vladgava/planck-led-esp32/planck_fit_ro.png

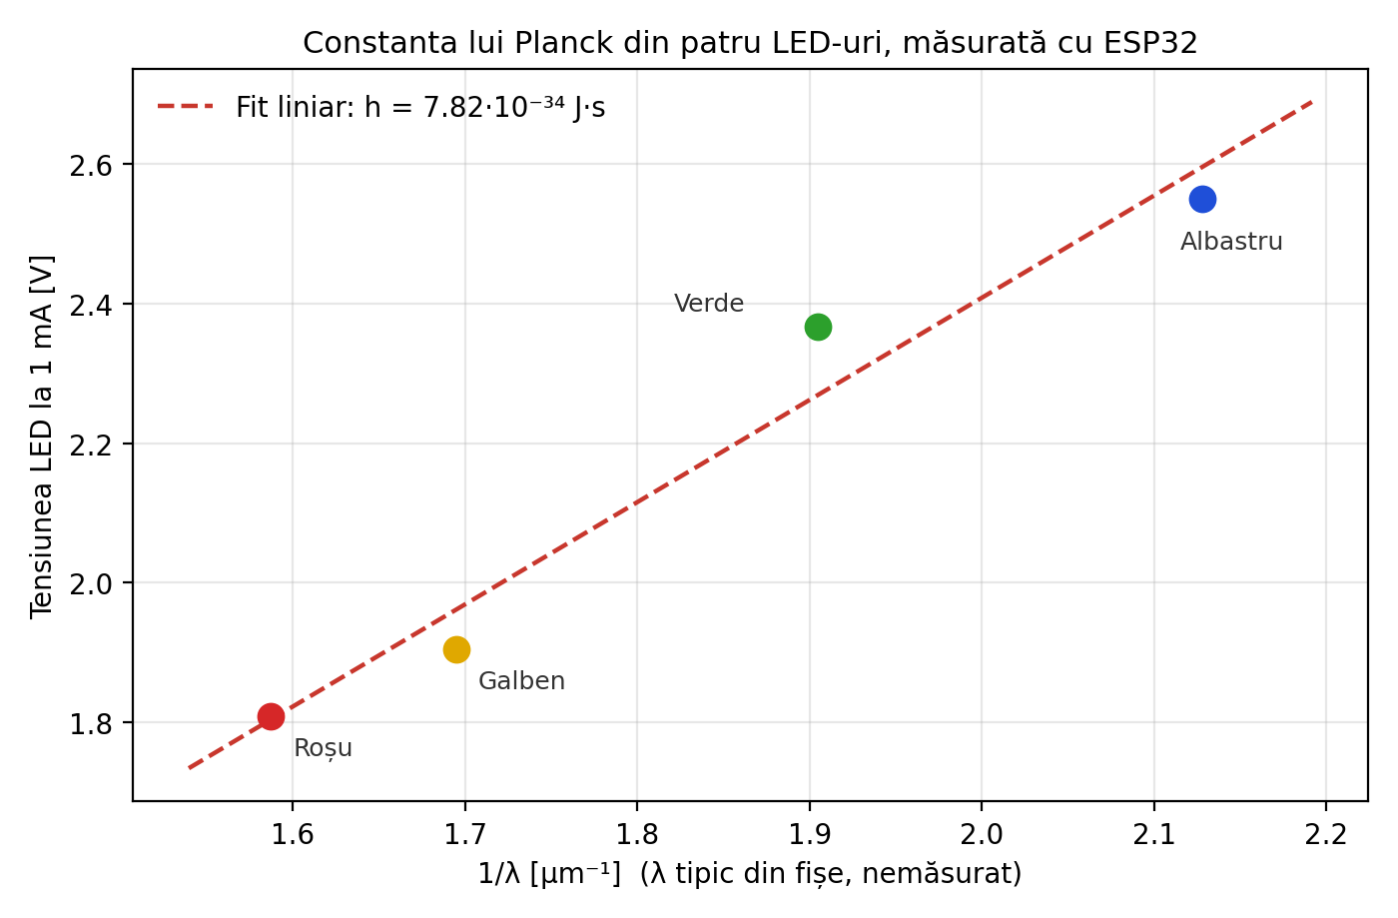
planck_fit_ro.png
